maya-taylor/Project2ELEC291/pythoncode/mic_off.png

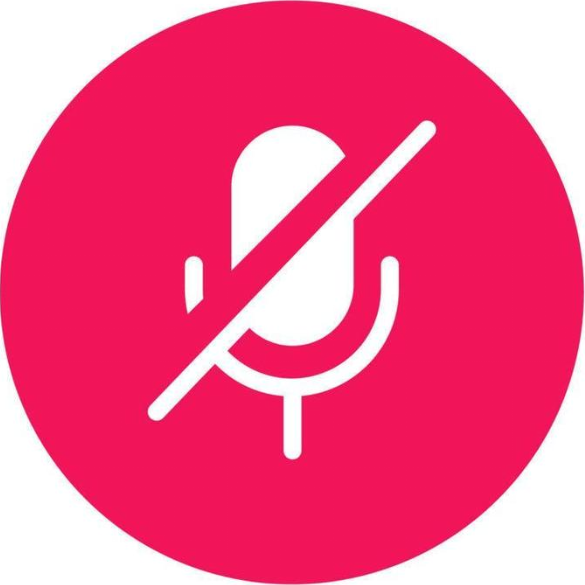
pythoncode/mic_off.png
