maya-taylor/Project2ELEC291/(list of files, cad)

Other CAD files:
integrated_files/EFM8integration.obj
JDY40 EFM8 Files/EFM8 Example Code/All_timers/All_timers.obj
JDY40 EFM8 Files/EFM8 Example Code/EFM8_Prog/EFM8_prog.obj
JDY40 EFM8 Files/efm8joystickjdyint.obj
Joystick-tester/working-joystick.obj
JoystickTestCode.obj
STM32L051-Sample-Codes/Servo_PWM/CrossIde1.obj
STM32L051-Sample-Codes/stm32flash/BO230/BO230.obj
STM32L051-Sample-Codes/WAV_Sound/computer_sender.obj
JDY40 EFM8 Files/CrossIde1.obj
