maya-taylor/Project2ELEC291/STM32L051-Sample-Codes/Servo_PWM/TestCode.xlsx

x | y | angle(rad) | angle (deg) | velocity | left PWM | right PWM | left adjust | right adjust
50 | 0 | 0 | 0 | 50 | 100 | 100 | 1 | -1
49 | 2 | 0.040794 | 2.337324029 | 49 | 98 | 97 | 1 | -0.996674
49 | 4 | 0.081452 | 4.666855833 | 49 | 98 | 96 | 1 | -0.98676
49 | 7 | 0.141897 | 8.130099226 | 49 | 98 | 94 | 1 | -0.96
49 | 9 | 0.181649 | 10.40772105 | 49 | 98 | 91 | 1 | -0.93473
48 | 12 | 0.244979 | 14.03626277 | 49 | 98 | 86 | 1 | -0.882353
47 | 14 | 0.289504 | 16.58735735 | 49 | 98 | 82 | 1 | -0.837006
46 | 17 | 0.353997 | 20.28253406 | 49 | 98 | 74 | 1 | -0.759667
46 | 19 | 0.3917 | 22.44275684 | 49 | 98 | 69 | 1 | -0.708518
45 | 21 | 0.436627 | 25.01688432 | 49 | 98 | 62 | 1 | -0.642336
43 | 23 | 0.491164 | 28.14162425 | 48 | 95 | 53 | 1 | -0.555088
42 | 26 | 0.554308 | 31.75950895 | 49 | 98 | 43 | 1 | -0.445902
41 | 28 | 0.599175 | 34.33019869 | 49 | 98 | 35 | 1 | -0.363894
39 | 30 | 0.655696 | 37.56861344 | 49 | 98 | 25 | 1 | -0.256506
38 | 32 | 0.699893 | 40.10091501 | 49 | 98 | 16 | 1 | -0.170178
36 | 34 | 0.756835 | 43.36345129 | 49 | 98 | 5 | 1 | -0.057096
34 | 35 | 0.79989 | 45.83032107 | 48 | 95 | 2 | 1 | 0.028979
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
