maya-taylor/Project2ELEC291/JDY40 EFM8 Files/efm8joystickjdyint.c

/* 	Function: Joystick Breadboard side Code
	Hardware:
	- Timer 0
	- Timer 2 => ISR which generates buzzer sound. Output on P2_4

	Global variables: 
		overflow_count --
		buff --

*/

#include <EFM8LB1.h>
#include <stdlib.h>
#include <stdio.h>
#include <string.h>
#include <math.h>

#define SYSCLK 72000000
#define BAUDRATE 115200L
#define SARCLK 18000000L
#define XPOS_PIN QFP32_MUX_P1_4
#define YPOS_PIN QFP32_MUX_P1_5

#define LCD_RS P1_7
#define LCD_E P1_6
#define LCD_D4 P1_3
#define LCD_D5 P1_2
#define LCD_D6 P1_1
#define LCD_D7 P1_0
#define CHARS_PER_LINE 16
#define MAX_VOLTS 3.3049  //this should stay consistent but maybe requires calibration (HY)
#define SQRT_2 1.41421356237 //saves computation time by using a constant (HY)

// Buzzer sound
#define BUZZER_OUT   P0_3  // sets buzzer output to pin 0.2
#define TR5_OUT_TEST P0_2 // 
//#define DEFAULT_F 15500L // 
#define DEFAULT_F 2000L
#define TIMER5_FREQ 1000L

// threshold values for many Hz above baseline frequency for different metal strengths
#define metalLevel_min 200
#define metalLevel_1   300
#define metalLevel_2   400
#define metalLevel_3   500
#define metalLevel_4   600
#define metalLevel_5   700

// buzzer frequencies for each strength level
#define min_freq       500   
#define level1_freq    800   
#define level2_freq    100
#define level3_freq    1200
#define level4_freq    1500
#define level5_freq    2000

// For normalizing joystick position 
#define external_voltage_reference 1.7854  // in volts


unsigned char overflow_count;

idata char buff[20];

volatile long int count_ms = 0;

// new global variables here
// extract_num, baseline_freq, min_metal_detect
volatile float extract_num = 0.0;
volatile float min_metal_detect = 200; //frequency increase at which metal is detected
volatile float baseline_freq = 0.0;

char _c51_external_startup (void)
{
	// Disable Watchdog with key sequence
	SFRPAGE = 0x00;
	WDTCN = 0xDE; //First key
	WDTCN = 0xAD; //Second key
  
	VDM0CN=0x80;       // enable VDD monitor
	RSTSRC=0x02|0x04;  // Enable reset on missing clock detector and VDD

	#if (SYSCLK == 48000000L)	
		SFRPAGE = 0x10;
		PFE0CN  = 0x10; // SYSCLK < 50 MHz.
		SFRPAGE = 0x00;
	#elif (SYSCLK == 72000000L)
		SFRPAGE = 0x10;
		PFE0CN  = 0x20; // SYSCLK < 75 MHz.
		SFRPAGE = 0x00;
	#endif
	
	#if (SYSCLK == 12250000L)
		CLKSEL = 0x10;
		CLKSEL = 0x10;
		while ((CLKSEL & 0x80) == 0);
	#elif (SYSCLK == 24500000L)
		CLKSEL = 0x00;
		CLKSEL = 0x00;
		while ((CLKSEL & 0x80) == 0);
	#elif (SYSCLK == 48000000L)	
		// Before setting clock to 48 MHz, must transition to 24.5 MHz first
		CLKSEL = 0x00;
		CLKSEL = 0x00;
		while ((CLKSEL & 0x80) == 0);
		CLKSEL = 0x07;
		CLKSEL = 0x07;
		while ((CLKSEL & 0x80) == 0);
	#elif (SYSCLK == 72000000L)
		// Before setting clock to 72 MHz, must transition to 24.5 MHz first
		CLKSEL = 0x00;
		CLKSEL = 0x00;
		while ((CLKSEL & 0x80) == 0);
		CLKSEL = 0x03;
		CLKSEL = 0x03;
		while ((CLKSEL & 0x80) == 0);
	#else
	#error SYSCLK must be either 12250000L, 24500000L, 48000000L, or 72000000L
	#endif
	
	P0MDOUT |= 0x11; // Enable UART0 TX (P0.4) and UART1 TX (P0.0) as push-pull outputs
	P2MDOUT |= 0x01; // P2.0 in push-pull mode
	XBR0     = 0x01; // Enable UART0 on P0.4(TX) and P0.5(RX)                     
	XBR1     = 0X00;
	XBR2     = 0x41; // Enable crossbar and uart 1

	// Configure Uart 0
	#if (((SYSCLK/BAUDRATE)/(2L*12L))>0xFFL)
		#error Timer 0 reload value is incorrect because (SYSCLK/BAUDRATE)/(2L*12L) > 0xFF
	#endif
	SCON0 = 0x10;
	TH1 = 0x100-((SYSCLK/BAUDRATE)/(2L*12L));
	TL1 = TH1;      // Init Timer1
	TMOD &= ~0xf0;  // TMOD: timer 1 in 8-bit auto-reload
	TMOD |=  0x20;                       
	TR1 = 1; // START Timer1
	TI = 1;  // Indicate TX0 ready

	
	// Initialize timer 2 for periodic interrupts
	SFRPAGE=0x10;
	TMR2CN0=0x00;   // Stop Timer2; Clear TF2;
	CKCON0|=0b_0001_0000; 
	TMR2RL=(-(SYSCLK/(2*DEFAULT_F))); // Initialize reload value
	TMR2=0xffff;   // Set to reload immediately
	ET2=1;         // Enable Timer2 interrupts
	TR2=1;         // Start Timer2

	// Initializer timer5
	SFRPAGE=0x10;
	TMR5CN0=0x00;   // Stop Timer5; Clear TF5; WARNING: lives in SFR page 0x10
	CKCON1|=0b_0000_0100; // Timer 5 uses the system clock
	TMR5RL=(0x10000L-(SYSCLK/(2*TIMER5_FREQ))); // Initialize reload value
	TMR5=0xffff;   // Set to reload immediately
	EIE2|=0b_0000_1000; // Enable Timer5 interrupts
	TR5=1;         // Start Timer5 (TMR5CN0 is bit addressable)

	EA=1; // Global interrupt enable
  	
	return 0;
}

void Timer2_ISR (void) interrupt INTERRUPT_TIMER2
{
	SFRPAGE=0x10;
	TF2H = 0; // Clear Timer2 interrupt flag
	BUZZER_OUT =! BUZZER_OUT; // complements the value of BUZZER_OUT to generate a square wave
}
// Timer 5 controls the output of timer2
void Timer5_ISR (void) interrupt INTERRUPT_TIMER5
{
	int lengthBeeps;
	SFRPAGE=0x10;
	TF5H = 0;
	TR5_OUT_TEST =! TR5_OUT_TEST; // generates a continuous 1kHz wave. -- Debug to verify that ISR5 is running

	// depending on metal strength level, do a beep with a particular frequency
	
	count_ms++;

	if (extract_num > metalLevel_5 + baseline_freq){
 		lengthBeeps = 100; // highest frequency and longest period for length of beeps
		printf("BEEP 5\r\n");
	}	
	else if (extract_num > metalLevel_4 + baseline_freq){
 		lengthBeeps = 200;
		printf("BEEP 4\r\n");
	}
	else if (extract_num > metalLevel_3 + baseline_freq){
		lengthBeeps = 400;
		printf("BEEP 3\r\n");
	}
	else if (extract_num > metalLevel_2 + baseline_freq){
		lengthBeeps = 600;
		printf("BEEP 2\r\n");
	}
	else if (extract_num > metalLevel_1 + baseline_freq){
		lengthBeeps = 800;
		printf("BEEP 1\r\n");
	}
	else if (extract_num > min_metal_detect + baseline_freq){
		lengthBeeps = 1000;
		printf("BEEP\r\n");
	}
	else {
		// turns off timer2 - used for testing
		lengthBeeps = -1;
		TR2=0;
	}
	//printf("beep\r\n");
	//lengthBeeps = 1000;

	lengthBeeps = 1000;

	if (count_ms >= lengthBeeps) {
		if (TR2 == 0)
			TR2 = 1; // Enable / disable timer2 interrupts
		else
			TR2 = 0;

		count_ms = 0;		
	}
	
}


void InitADC (void)
{
	SFRPAGE = 0x00;
	ADEN=0; // Disable ADC
	
	ADC0CN1=
		(0x2 << 6) | // 0x0: 10-bit, 0x1: 12-bit, 0x2: 14-bit
        (0x0 << 3) | // 0x0: No shift. 0x1: Shift right 1 bit. 0x2: Shift right 2 bits. 0x3: Shift right 3 bits.		
		(0x0 << 0) ; // Accumulate n conversions: 0x0: 1, 0x1:4, 0x2:8, 0x3:16, 0x4:32
	
	ADC0CF0=
	    ((SYSCLK/SARCLK) << 3) | // SAR Clock Divider. Max is 18MHz. Fsarclk = (Fadcclk) / (ADSC + 1)
		(0x0 << 2); // 0:SYSCLK ADCCLK = SYSCLK. 1:HFOSC0 ADCCLK = HFOSC0.
	
	ADC0CF1=
		(0 << 7)   | // 0: Disable low power mode. 1: Enable low power mode.
		(0x1E << 0); // Conversion Tracking Time. Tadtk = ADTK / (Fsarclk)
	
	ADC0CN0 =
		(0x0 << 7) | // ADEN. 0: Disable ADC0. 1: Enable ADC0.
		(0x0 << 6) | // IPOEN. 0: Keep ADC powered on when ADEN is 1. 1: Power down when ADC is idle.
		(0x0 << 5) | // ADINT. Set by hardware upon completion of a data conversion. Must be cleared by firmware.
		(0x0 << 4) | // ADBUSY. Writing 1 to this bit initiates an ADC conversion when ADCM = 000. This bit should not be polled to indicate when a conversion is complete. Instead, the ADINT bit should be used when polling for conversion completion.
		(0x0 << 3) | // ADWINT. Set by hardware when the contents of ADC0H:ADC0L fall within the window specified by ADC0GTH:ADC0GTL and ADC0LTH:ADC0LTL. Can trigger an interrupt. Must be cleared by firmware.
		(0x0 << 2) | // ADGN (Gain Control). 0x0: PGA gain=1. 0x1: PGA gain=0.75. 0x2: PGA gain=0.5. 0x3: PGA gain=0.25.
		(0x0 << 0) ; // TEMPE. 0: Disable the Temperature Sensor. 1: Enable the Temperature Sensor.

	ADC0CF2= 
		(0x0 << 7) | // GNDSL. 0: reference is the GND pin. 1: reference is the AGND pin.
		(0x1 << 5) | // REFSL. 0x0: VREF pin (external or on-chip). 0x1: VDD pin. 0x2: 1.8V. 0x3: internal voltage reference.
		(0x1F << 0); // ADPWR. Power Up Delay Time. Tpwrtime = ((4 * (ADPWR + 1)) + 2) / (Fadcclk)
	
	ADC0CN2 =
		(0x0 << 7) | // PACEN. 0x0: The ADC accumulator is over-written.  0x1: The ADC accumulator adds to results.
		(0x0 << 0) ; // ADCM. 0x0: ADBUSY, 0x1: 	, 0x2: TIMER2, 0x3: TIMER3, 0x4: CNVSTR, 0x5: CEX5, 0x6: Timer5, 0x7: TIMER5, 0x8: CLU0, 0x9: CLU1, 0xA: CLU2, 0xB: CLU3

	ADEN=1; // Enable ADC
}

// Uses Timer3 to delay <us> micro-seconds. 
void Timer3us(unsigned char us)
{
	unsigned char i;               // usec counter
	
	// The input for Timer 3 is selected as SYSCLK by setting T3ML (bit 6) of CKCON0:
	CKCON0|=0b_0100_0000;
	
	TMR3RL = (-(SYSCLK)/1000000L); // Set Timer3 to overflow in 1us.
	TMR3 = TMR3RL;                 // Initialize Timer3 for first overflow
	
	TMR3CN0 = 0x04;                 // Sart Timer3 and clear overflow flag
	for (i = 0; i < us; i++)       // Count <us> overflows
	{
		while (!(TMR3CN0 & 0x80));  // Wait for overflow
		TMR3CN0 &= ~(0x80);         // Clear overflow indicator
	}
	TMR3CN0 = 0 ;                   // Stop Timer3 and clear overflow flag
}

void waitms (unsigned int ms)
{
	unsigned int j;
	unsigned char k;
	for(j=0; j<ms; j++)
		for (k=0; k<4; k++) Timer3us(250);
}

#define VDD 3.3035 // The measured value of VDD in volts

void InitPinADC (unsigned char portno, unsigned char pinno)
{
	unsigned char mask;
	
	mask=1<<pinno;

	SFRPAGE = 0x20;
	switch (portno)
	{
		case 0:
			P0MDIN &= (~mask); // Set pin as analog input
			P0SKIP |= mask; // Skip Crossbar decoding for this pin
		break;
		case 1:
			P1MDIN &= (~mask); // Set pin as analog input
			P1SKIP |= mask; // Skip Crossbar decoding for this pin
		break;
		case 2:
			P2MDIN &= (~mask); // Set pin as analog input
			P2SKIP |= mask; // Skip Crossbar decoding for this pin
		break;
		default:
		break;
	}
	SFRPAGE = 0x00;
}

void TIMER0_Init(void)
{
	TMOD&=0b_1111_0000; // Set the bits of Timer/Counter 0 to zero
	TMOD|=0b_0000_0001; // Timer/Counter 0 used as a 16-bit timer
	TR0=0; // Stop Timer/Counter 0
}

unsigned int ADC_at_Pin(unsigned char pin)
{
	ADC0MX = pin;   // Select input from pin
	ADINT = 0;
	ADBUSY = 1;     // Convert voltage at the pin
	while (!ADINT); // Wait for conversion to complete
	return (ADC0);
}

unsigned int Get_ADC (void)
{
	ADINT = 0;
	ADBUSY = 1;
	while (!ADINT); // Wait for conversion to complete
	return (ADC0);
}


float Volts_at_Pin(unsigned char pin)
{
	 return ((ADC_at_Pin(pin)*VDD)/0b_0011_1111_1111_1111);
}


void LCD_pulse (void)
{
	LCD_E=1;
	Timer3us(40);
	LCD_E=0;
}

void LCD_byte (unsigned char x)
{
	// The accumulator in the C8051Fxxx is bit addressable!
	ACC=x; //Send high nible
	LCD_D7=ACC_7;
	LCD_D6=ACC_6;
	LCD_D5=ACC_5;
	LCD_D4=ACC_4;
	LCD_pulse();
	Timer3us(40);
	ACC=x; //Send low nible
	LCD_D7=ACC_3;
	LCD_D6=ACC_2;
	LCD_D5=ACC_1;
	LCD_D4=ACC_0;
	LCD_pulse();
}


void WriteData (unsigned char x)
{
	LCD_RS=1;
	LCD_byte(x);
	waitms(2);
}

void WriteCommand (unsigned char x)
{
	LCD_RS=0;
	LCD_byte(x);
	waitms(5);
}

void LCD_4BIT (void)
{
	LCD_E=0; // Resting state of LCD's enable is zero
	// LCD_RW=0; // We are only writing to the LCD in this program
	waitms(20);
	// First make sure the LCD is in 8-bit mode and then change to 4-bit mode
	WriteCommand(0x33);
	WriteCommand(0x33);
	WriteCommand(0x32); // Change to 4-bit mode
	// Configure the LCD
	WriteCommand(0x28);
	WriteCommand(0x0c);
	WriteCommand(0x01); // Clear screen command (takes some time)
	waitms(20); // Wait for clear screen command to finsih.
}

void LCDprint(char * string, unsigned char line, bit clear)
{
	int j;
	WriteCommand(line==2?0xc0:0x80);
	waitms(5);
	for(j=0; string[j]!=0; j++) WriteData(string[j]);// Write the message
	if(clear) for(; j<CHARS_PER_LINE; j++) WriteData(' '); // Clear the rest ofthe line
}

float map2(float x, float in_min, float in_max, float out_min, float out_max)
{
	//float tempa, tempb, tempc, tempd, tempe, tempf;
	
	//tempa = (x - in_min);
	//printf("%f\r\n", tempa);
	//tempb = (out_max - out_min);
	//printf("%f\r\n", tempb);
	//tempc = tempa * tempb;
	//printf("%f\r\n", tempc);
	//tempd = (in_max - in_min);
	//printf("%f\r\n", tempd);
	//tempe = (float)tempc/(float)tempd;
	//printf("%f\r\n", tempe);
	//tempf = tempe+ out_min;
	//printf("%f\r\n", tempf);
	
	float value =  (x - in_min) * (out_max - out_min) / (in_max - in_min) + out_min;
    return value;
}

void GetPosition2 (float volts[2], float pos[2]) {
	//float zero_x, zero_y, max_x, max_y;
    float mov_x = 0.0;
    float mov_y = 0.0;
	// approx values
	float mid_x = 2.30;
	float mid_y = 2.35;


	float vx = volts[0];
	float vy = volts[1];

	if (pos[0] < mid_x) {
		pos[0] = map2(vx, 0.0, mid_x, -50.0, 0);
		//printf("neg x\r\n");

	}
	else {
		pos[0] = map2(vx, mid_x, 3.3, 0.0, 50.0);
		//printf("pos x\r\n");
	}

	if (pos[1] < mid_y) {
		pos[1] = map2(vy, 0.0, mid_y, -50.0, 0.0);
		//printf("neg y\r\n");
	}
	else {
		pos[1] = map2(vy, mid_y, 3.3, 0.0, 50.0);
		//printf("pos y\r\n");
	}
	// pos[0] = map2(vx, 0.0, 3.3, -50.0, 50.0);
	// pos[1] = map2(vy, 0.0, 3.3, -50.0, 50.0);

	//mov_x = pos[0];
	//mov_y = pos[1];
    
    //print to serial
    //printf("xpos: %s ypos: %s\r\n", buff_x, buff_y);
}

void UART1_Init (unsigned long baudrate)
{
    SFRPAGE = 0x20;
	SMOD1 = 0x0C; // no parity, 8 data bits, 1 stop bit
	SCON1 = 0x10;
	SBCON1 =0x00;   // disable baud rate generator
	SBRL1 = 0x10000L-((SYSCLK/baudrate)/(12L*2L));
	TI1 = 1; // indicate ready for TX
	SBCON1 |= 0x40;   // enable baud rate generator
	SFRPAGE = 0x00;
}

void putchar1 (char c) 
{
    SFRPAGE = 0x20;
	while (!TI1);
	TI1=0;
	SBUF1 = c;
	SFRPAGE = 0x00;
}

void sendstr1 (char * s)
{
	while(*s)
	{
		putchar1(*s);
		s++;	
	}
}

char getchar1 (void)
{
	char c;
    SFRPAGE = 0x20;
	while (!RI1);
	RI1=0;
	// Clear Overrun and Parity error flags 
	SCON1&=0b_0011_1111;
	c = SBUF1;
	SFRPAGE = 0x00;
	return (c);
}

char getchar1_with_timeout (void)
{
	char c;
	unsigned int timeout;
    SFRPAGE = 0x20;
    timeout=0;
	while (!RI1)
	{
		SFRPAGE = 0x00;
		Timer3us(20);
		SFRPAGE = 0x20;
		timeout++;
		if(timeout==25000)
		{
			SFRPAGE = 0x00;
			return ('\n'); // Timeout after half second
		}
	}
	RI1=0;
	// Clear Overrun and Parity error flags 
	SCON1&=0b_0011_1111;
	c = SBUF1;
	SFRPAGE = 0x00;
	return (c);
}


void getstr1 (char * s)
{
	char c;
	
	while(1)
	{
		c=getchar1_with_timeout();
		if(c=='\n')
		{
			*s=0;
			return;
		}
		*s=c;
		s++;
	}
}

// RXU1 returns '1' if there is a byte available in the receive buffer of UART1
bit RXU1 (void)
{
	bit mybit;
    SFRPAGE = 0x20;
	mybit=RI1;
	SFRPAGE = 0x00;
	return mybit;
}

void waitms_or_RI1 (unsigned int ms)
{
	unsigned int j;
	unsigned char k;
	for(j=0; j<ms; j++)
	{
		for (k=0; k<4; k++)
		{
			if(RXU1()) return;
			Timer3us(250);
		}
	}
}

void SendATCommand (char * s)
{
	printf("Command: %s", s);
	P2_0=0; // 'set' pin to 0 is 'AT' mode.
	waitms(5);
	sendstr1(s);
	getstr1(buff);
	waitms(10);
	P2_0=1; // 'set' pin to 1 is normal operation mode.
	printf("Response: %s\r\n", buff);
}

// Turns on timer2 so that buzzer plays a sound `freq`
// Param: freq -- frequency that timer2 will play at
void loadTimer2(unsigned long int freq) {
	unsigned long int x=(SYSCLK/(2L*freq));

	TR2=0; // Stop timer 2
	TMR2RL=0x10000L-x; // Change reload value for new frequency
	TR2=1; // Start timer 2
}

/*
	Function:
		If freq is above a threshold(baseline + min_metal_detect), play sound
		Frequency of sound is dependent on amount above baseline
		Different threshold levels are given by 
		`metalLevel_x`which corresponds to `levelx_freq`

	Params:
		detectedFreq - measured frequency of circuit
		min_metal_detect - minimum value above baseline for us to consider there's a coin
		baselinefreq - measured baseline frequency


*/
// void playBuzzerSound (float extract_num, float min_metal_detect, float baseline_freq) {
// 	return;
// 	// minimum frequency
//  	// if (extract_num > min_metal_detect + baseline_freq){
//  	// 	loadTimer2((extract_num - baseline_freq-min_metal_detect)*3 +400);
// 	// 	printf("BEEP\r\n");
// 	// }	
// 	// else if (extract_num > metalLevel_4 + baseline_freq){
// 	// 	loadTimer2(level4_freq);
// 	// 	printf("BEEP 4\r\n");
// 	// }
// 	// else if (extract_num > metalLevel_3 + baseline_freq){
// 	// 	loadTimer2(level3_freq);
// 	// 	printf("BEEP 3\r\n");
// 	// }
// 	// else if (extract_num > metalLevel_2 + baseline_freq){
// 	// 	loadTimer2(level2_freq);
// 	// 	printf("BEEP 2\r\n");
// 	// }
// 	// else if (extract_num > metalLevel_1 + baseline_freq){
// 	// 	loadTimer2(level1_freq);
// 	// 	printf("BEEP 1\r\n");
// 	// }
// 	// else if (extract_num > min_metal_detect + baseline_freq){
// 	// 	loadTimer2(min_freq);
// 	// 	printf("BEEP\r\n");
// 	// }
// 	// 
// 	// else {
// 	//	TR2 = 0; 		// Stop timer 2
//  	//	BUZZER_OUT = 0; // turn off buzzer sound
//  	//	}
// // }
// }


// Initialization is done externally by c51? - GL
void main(void)
{
	//unsigned int cnt;
	// float extract_num = 0.0;
	float prev_num = 0.1;
	//int mapped_num; //for the beeping
	// float min_metal_detect = 200; //frequency increase at which metal is detected
	float mapped_range = 5.0; //1 to mapped_range+1
	float extract_range = 800.0; //max range of beeping frequency
	int timeout_cnt = 0;
	int sum_count = 0; //count to keep track of first 10 vals
	float sum_freq = 0.0; //where I am adding the frequencies into
	// float baseline_freq = 0.0;
	
	float v[2];
    float xy_pos[2]; //positioning array, xy_pos[0] corresponds to the x-coord, y-coord is the latter (HY)
	xdata char buff_x[17];
    xdata char buff_y[17];
	xdata char temp_buff[80];

	//EA=0; // Global interrupt disable

	//float adc[2]
	// TIMER0_Init();
	LCD_4BIT();
	
	waitms(500);
	printf("\x1b[2J"); // Clear screen using ANSI escape sequence.
	
	printf("ADC test program\n"
	        "File: %s\n"
	        "Compiled: %s, %s\n\n",
	        __FILE__, __DATE__, __TIME__);
	printf("\r\nJDY-40 test\r\n");
	UART1_Init(9600);

	InitPinADC(1, 4); // Configure P1.4 as analog input
	InitPinADC(1, 5); // Configure P1.5 as analog input
    InitADC();


	// To configure the device (shown here using default values).
	// For some changes to take effect, the JDY-40 needs to be power cycled.
	// Communication can only happen between devices with the
	// same RFID and DVID in the same channel.
	
	//SendATCommand("AT+BAUD4\r\n");
	//SendATCommand("AT+RFID8899\r\n");
	//SendATCommand("AT+DVID1122\r\n"); // Default device ID.
	//SendATCommand("AT+RFC001\r\n");
	//SendATCommand("AT+POWE9\r\n");
	//SendATCommand("AT+CLSSA0\r\n");
	
	// We should select an unique device ID.  The device ID can be a hex
	// number from 0x0000 to 0xFFFF.  In this case is set to 0xABBA
	SendATCommand("AT+DVIDBEEF\r\n");  

	// To check configuration
	SendATCommand("AT+VER\r\n");
	SendATCommand("AT+BAUD\r\n");
	SendATCommand("AT+RFID\r\n");
	SendATCommand("AT+DVID\r\n");
	SendATCommand("AT+RFC\r\n");
	SendATCommand("AT+POWE\r\n");
	SendATCommand("AT+CLSS\r\n");
	
	//printf("\r\nPress and hold the BOOT button to transmit.\r\n");
	
	//EA=1; // Global interrupt enable
  	

	//cnt=0;
	while(1)
	{
		waitms(50);

            
        v[0] = Volts_at_Pin(XPOS_PIN) ;
	    v[1] = Volts_at_Pin(YPOS_PIN) ;

       
		// printf("xvolts: %7.5f yvolts: %7.5f\r\n", ADC_at_Pin(XPOS_PIN), ADC_at_Pin(YPOS_PIN));
		// ADC 
		//printf("xadc: %7.5f yadc: %7.5f\r\n", ADC_at_Pin(XPOS_PIN), ADC_at_Pin(YPOS_PIN))
        
        GetPosition2(v, xy_pos);

		sprintf(buff_x, "x=%.4f", xy_pos[0]);
    	LCDprint(buff_x, 1, 1);
	    sprintf(buff_y, "y=%.4f", xy_pos[1]);
    	LCDprint(buff_y, 2, 1);
       
		//printf("xvolts: %7.5f yvolts: %7.5f\r\n", Volts_at_Pin(XPOS_PIN), Volts_at_Pin(YPOS_PIN));

		if (abs(xy_pos[0]) < 5) xy_pos[0]=0;
		if (abs(xy_pos[1]) < 5) xy_pos[1]=0;
		if (xy_pos[0] > 50) xy_pos[0]=50;
		if (xy_pos[1] > 50) xy_pos[1]=50;
		if (xy_pos[0] < -50) xy_pos[0]=-50;
		if (xy_pos[1] < -50) xy_pos[1]=-50;

        //sprintf(temp_buff, "xpos: %d ypos: %d\r\n", (int)xy_pos[0], (int)xy_pos[1]);
		//printf(temp_buff);
		sprintf(temp_buff, "%3d,%3d\r\n", (int)xy_pos[0], (int)xy_pos[1]);
        sendstr1(temp_buff);
        
		waitms(10);


		sendstr1("M\r\n");
		putchar('.');
			
		timeout_cnt = 0;
		while (1) 
		{
			TR5_OUT_TEST != TR5_OUT_TEST;
			if (RXU1()) break;
			waitms_or_RI1(1);
			timeout_cnt++;
			if (timeout_cnt>=500){
				printf("timeout \r\n");
				break;
			 }
		}
		if (RXU1()) 
		{
			getstr1(buff);
			if(strlen(buff) == 10)
			{
				//need to test sum_count part still but should work
				printf("RX: %s\r\n", buff);
				extract_num = atof(buff);
				printf("extracted: %f\r\n", extract_num);
				if(sum_count < 10)
				{
					sum_freq = extract_num + sum_freq;
					sum_count++;
				}
				if(sum_count == 10)
				{
					baseline_freq = sum_freq/10.0;
					printf("baseline freq :%f\r\n", baseline_freq);
					sum_count++;
				}	
				if(sum_count > 10)
				{
					// //now we can start detecting
					// playBuzzerSound(extract_num, min_metal_detect, baseline_freq);
				}
				
			}
		}
	}
}
