maya-taylor/Project2ELEC291/bonusideas/metalLocation.py

'''
purpose: create a metalography chart in cartesian coordinates
info   : loci with higher metal density (a.k.a., frequency difference is bigger) will appear more 
         red, whilst loci with lower metal density will appear more purple 
'''

import time
import re
import matplotlib.pyplot as plt
import pygame 
import csv
import random
 

FILE = 'serial_data_log.csv' #edit!!!

# RGB values for light colors
lightorange = (255/255, 204/255, 153/255)
lightyellow = (255/255, 255/255, 153/255)
lightgreen  = (204/255, 255/255, 204/255)
lightblue   = (153/255, 204/255, 255/255)
lightpurple = (204/255, 153/255, 255/255)
lightred    = (255/255, 153/255, 153/255)   

# Define the ASCII characters marking the three specific kinds of data

#flags for x, y loci
ff_flag       = 'A' #forward fast
fm_flag       = 'B'
fs_flag       = 'C'
bf_flag       = 'D'
bm_flag       = 'E'
bs_flag       = 'F'
cwf_flag      = 'G'
cwm_flag      = 'H'
ccwf_flag     = 'I'
ccwm_flag     = 'J'
ne_flag       = 'K'
nw_flag       = 'L'
se_flag       = 'M'
sw_flag       = 'N'
no_movmt_flag = 'Z'

#flags for strength
level_1     = 'a'
level_2     = 'b'
level_3     = 'c'
level_4     = 'd'
level_5     = 'e'
null_detect = 'z'

L1F          = 225
L2F          = 300
L3F          = 400
L4F          = 500
L5F          = 700
LOW_STRENGTH = 0



def process_csv(filename):
    with open(filename, 'r') as file: # Open the CSV file
        reader         = csv.reader(file) # Create a CSV reader object
        coord_map      = [] #dynamic initialization of x,y
        strength_map   = [] #dynamic initialization of strength value
        xpos           = 0 #variables that are used as buffers 
        ypos           = 0
        metal_strength = 0
        # Iterate through each row in the CSV file
        for row in reader:
            # Assuming one column in the CSV file
            data       = row[0]
            
            # Check if the data contains location flags and process accordingly
            if ff_flag in data:
                xpos  += 0
                ypos  += 50
            elif fm_flag in data:
                xpos  += 0
                ypos  += 30
            elif fs_flag in data:
                xpos  += 0
                ypos  += 20
            elif bf_flag in data:
                xpos  += 0
                ypos  += -50
            elif bm_flag in data:
                xpos  += 0
                ypos  += -30
            elif bs_flag in data:
                xpos  += 0
                ypos  += -10
            elif cwf_flag in data:
                xpos  += 50
                ypos  += 0
            elif cwm_flag in data:
                xpos  += 30
                ypos  += 0
            elif ccwf_flag in data:
                xpos  += -50
                ypos  += 0
            elif ccwm_flag in data:
                xpos  += -30
                ypos  += 0
            elif ne_flag in data:
                xpos  += 20
                ypos  += 45
            elif nw_flag in data:
                xpos  += -20
                ypos  += 45
            elif se_flag in data:
                xpos  += 20
                ypos  += -45
            elif sw_flag in data:
                xpos  += -20
                ypos  += -45
            else: #default case is no movement so we add nothing new
                xpos  += 0
                ypos  += 0
            
            coord_map.append([xpos, ypos])

            if level_1 in data:
                metal_strength = L1F
            elif level_2 in data:
                metal_strength = L2F
            elif level_3 in data:
                metal_strength = L3F
            elif level_4 in data:
                metal_strength = L4F
            elif level_5 in data:
                metal_strength = L5F
            elif null_detect in data:
                metal_strength = LOW_STRENGTH
            else:
                metal_strength += 0 #retain previous state as a default
            
            strength_map.append(metal_strength)

            print(xpos)
            print(ypos)
            print(metal_strength)

    return coord_map, strength_map
        

#drawing the map below 





#testing:
#num_rows = 30
#dummy_data = dummy_data_gen(num_rows)
#dummy_file_gen(FILE, dummy_data, num_rows)


coords, strengths = process_csv(FILE)

for coords, strengths in zip(coords, strengths):
    x, y = coords

    if strengths == L1F:
        plt.scatter(x, y, color= lightorange)
    elif strengths == L2F:
        plt.scatter(x, y, color=lightyellow)
    elif strengths == L3F:
        plt.scatter(x, y, color=lightgreen)
    elif strengths == L4F:
        plt.scatter(x, y, color=lightblue)   
    elif strengths == L5F:
        plt.scatter(x, y, color=lightpurple)
    else:
        plt.scatter(x, y, color=lightred)         

plt.xlabel('X coordinate')
plt.ylabel('Y coordinate')
plt.title('Metal Topography Chart')

plt.show()
'''

ideas:

    * calibrate a starting location/home base, could use joy stick pushbutto to decide this
    * keep track of location of the car relative to the home base (could incorporate whatever george has with this)
    * when metal is detected it will save the xy cord into a list or something, maybe a dict
    * can map the whole thing out into like a treasure map of where all the coins are hidden 

'''
