maya-taylor/Project2ELEC291/JDY40 EFM8 Files/EFM8 Example Code/EFM8_Prog/AN945/AN945SW/Firmware/EFM8BB1_SLSTK2020A/RainbowBlinky/src/main.c

//-----------------------------------------------------------------------------
// main.c
//-----------------------------------------------------------------------------
// Copyright 2014 Silicon Laboratories, Inc.
// http://developer.silabs.com/legal/version/v11/Silicon_Labs_Software_License_Agreement.txt
//
// Program Description:
//
// This example demonstrates the RGB LED using the joystick to control the color
// output.
//
//-----------------------------------------------------------------------------
// How To Test: EFM8BB1 STK
//-----------------------------------------------------------------------------
// 1) Place the SW104 switch in "AEM" mode.
// 2) Connect the EFM8BB1 STK board to a PC using a mini USB cable.
// 3) Compile and download code to the EFM8BB1 STK board.
//    In Simplicity Studio IDE, select Run -> Debug from the menu bar,
//    click the Debug button in the quick menu, or press F11.
// 4) Run the code.
//    In Simplicity Studio IDE, select Run -> Resume from the menu bar,
//    click the Resume button in the quick menu, or press F8.
// 5) The Rainbow Blinky demo should start.
// 6) Use the Joystick to change the color of the RGB LED:
//    Up         - Red
//    Up/Right   - Orange
//    Right      - Yellow
//    Down/Right - Green
//    Down       - Blue
//    Down/Left  - Indigo
//    Left       - Violet
//    Up/Left    - White
// 7) The selected color will be displayed on the LCD.
//
// Target:         EFM8BB1
// Tool chain:     Generic
//
// Release 0.1 (CM)
//    - Initial Revision
//    - 10 OCT 2014
//
//-----------------------------------------------------------------------------
// Resources
//-----------------------------------------------------------------------------
// SYSCLK - 24.5 MHz HFOSC0 / 1
// ADC0   - 10-bit
// SPI0   - 1 MHz
// Timer0 - 2 kHz (ADC start of conversion)
// Timer2 - 2 MHz (SPI CS delay)
// Timer3 - 1 kHz (1 ms tick)
// P0.0 - Display enable
// P0.1 - CS (Active High)
// P0.2 - push button
// P0.3 - push button
// P0.6 - SCK
// P1.0 - MOSI
// P1.4 - LED Green
// P1.5 - LED Blue
// P1.6 - LED Red
// P1.7 - Joystick (analog voltage divider)
//

//-----------------------------------------------------------------------------
// Includes
//-----------------------------------------------------------------------------

#include "bsp.h"
#include "InitDevice.h"
#include "disp.h"
#include "tick.h"
#include "rainbowblinky.h"

//-----------------------------------------------------------------------------
// main() Routine
// ----------------------------------------------------------------------------
int main(void)
{
  uint16_t lastTick;

  // Enter default mode
  enter_DefaultMode_from_RESET();

  // Enable all interrupts
  IE_EA = 1;

  DISP_Init();
  RainbowBlinky_Init();

  // Update when system tick is updated
  // Otherwise, idle to save power
  lastTick = GetTickCount();
  while (1)
  {
    // Idle until an interrupt wakes us up
    PCON0 = PCON0_IDLE__IDLE | PCON0_STOP__NORMAL;

    // Check to see if a millisecond has elapsed
    // Wakeup source might not be timer
    if ((GetTickCount() - lastTick) >= 10)
    {
      // Update ticks counter
      lastTick = GetTickCount();

      // Update display and parse input
      RainbowBlinky_Update();

      // Update LED Waveform
      RainbowBlinky_UpdateLED();
    }
  }
}
