maya-taylor/Project2ELEC291/JDY40 EFM8 Files/EFM8 Example Code/EFM8_Prog/AN945/AN945SW/Firmware/EFM8BB3_SLSTK2022A/Bootloader/UART/inc/efm8_device.h

/******************************************************************************
 * Copyright (c) 2015 by Silicon Laboratories Inc. All rights reserved.
 *
 * http://developer.silabs.com/legal/version/v11/Silicon_Labs_Software_License_Agreement.txt
 *****************************************************************************/

#ifndef __EFM8_DEVICE_H__
#define __EFM8_DEVICE_H__

#ifdef __C51__
#include "SI_EFM8BB3_Register_Enums.h"
#else
#include "SI_EFM8BB3_Defs.inc"
#endif

// Select the STK device if one has not been specified by the project
#ifndef EFM8BB3_DEVICE
#define EFM8BB3_DEVICE EFM8BB31F64G_QFN32
#endif
#include "SI_EFM8BB3_Devices.h"

// Bootloader firmware revision number
#define BL_REVISION 0x90

// Device specific ID is checked by the prefix command
#define BL_DERIVATIVE_ID (0x3400 | DEVICE_DERIVID)

// Holding the boot pin low at reset will start the bootloader
#if defined(DEVICE_PKG_QFN32) || defined(DEVICE_PKG_QFP32)
#define BL_START_PIN P3_B7

#elif defined(DEVICE_PKG_QFN24) || defined(DEVICE_PKG_QSOP24)
#define BL_START_PIN P3_B0

#else
#error Unknown or unsupported device package!

#endif

// Number of cycles (at reset system clock) boot pin must be held low
#define BL_PIN_LOW_CYCLES (50 * 25 / 8)

// Parameters that describe the flash memory geometry
#define BL_FLASH1_START 0xFA00
#define BL_FLASH1_LIMIT 0xFC00
#define BL_FLASH1_PSIZE 512

// Define range bootloader is allowed to write
#if DEVICE_FLASH_SIZE < BL_FLASH1_START
#define BL_FLASH0_LIMIT DEVICE_FLASH_SIZE
#else
#define BL_FLASH0_LIMIT BL_FLASH1_START
#endif

// Define the starting address for the bootloader's code segments
#define BL_LIMIT_ADDRESS (BL_FLASH1_START)
#define BL_START_ADDRESS (BL_FLASH1_START)
#define BL_LOCK_ADDRESS  (BL_FLASH1_LIMIT - 1)

// Defines for managing SFR pages (used for porting between devices)
#define SET_SFRPAGE(p)  SFRPAGE = (p)

#endif // __EFM8_DEVICE_H__
