maya-taylor/Project2ELEC291/(commit log)

2024-03-16 Added Relevant STM Files and PDFs from Canvas
    [BO230.obj, computer_sender.obj]
2024-03-18 Functional Joystick I/O
    We can analog read from the joystick and translate the 0V - 3.0349V range into a cartesian plane form such that 0V is negative; we have set up constants/places where we can add conversion factors the voltage readings into distance we want to move the car.
    [JoystickTestCode.obj]
2024-03-19 joystick works
    [JoystickTestCode.obj]
2024-03-22 Motor control code - tested in software and plotted in excel
2024-03-23 Commented motor test code
2024-03-23 Increase number of readings for noise reduction
    [main.c]
2024-03-25 Metal Detection and Motor Code update
    [BO230.obj, computer_sender.obj]
2024-03-26 motor changes
2024-03-28 UNTESTED - Servo_PWM code
    [JoystickTestCode.obj, TestCode.xlsx]
2024-03-31 Buzzer and pathfinding implemented -- Buzzer untested
    [TestCode.xlsx]
2024-03-31 Buzzer implemented and tested -- somewhat functional
    [efm8joystickjdyint.c]
2024-03-31 Periodic buzzing sound working
    [All_timers.obj, efm8joystickjdyint.obj]
2024-04-02 Revert "csv generated"
    This reverts commit 5cdabbec8fb4e58a5b44afd5a59d9437423b9525.
    [serialreader.py]
2024-04-02 Revert "Create wasd.py"
    This reverts commit 8ce04d6582765d99c740dd9b9e5d80694b2a3727.
    [wasd.py]
2024-04-02 Revert "Merge branch 'main' of https://github.com/maya-taylor/Project2ELEC291"
    This reverts commit 24f58df01cdae4c356d0b5eb3fd630fa4a455e09, reversing
    changes made to 3583c38671b796c17b95ad80d2e2d0c2f142eeda.
    [EFM8integration.c]
2024-04-02 python changes
    [EFM8integration.obj]
2024-04-02 diagonals and wasd working + printing to terminal
    if using up-down-left-right, ie. WASD, type the letter followed by anything that isn't these four letters
    if using this for diagonals, type w then a, a then s, s then d, or d then w - to move first in the direction of the first value and then in a diagonal
2024-04-02 Create metalmapperbackup
    dropping it here just in case any merge conflicts occur
2024-04-04 comments and formatting for STM32integration.c
2024-04-12 Add all robot/STM32 code in one folder
