maya-taylor/Project2ELEC291/(notices)

Notices in the files:
JDY40 EFM8 Files/EFM8 Example Code/EFM8_Prog/EFM8_prog.c:
under the terms of the GNU General Public License as published by the
Free Software Foundation; either version 2, or (at your option) any
